DroneAid-Parts/OpenFC-Lite/hardware/OpenFC.kicad_pcb

## KiCad design hardware/OpenFC.kicad_pcb (2026-10-15)

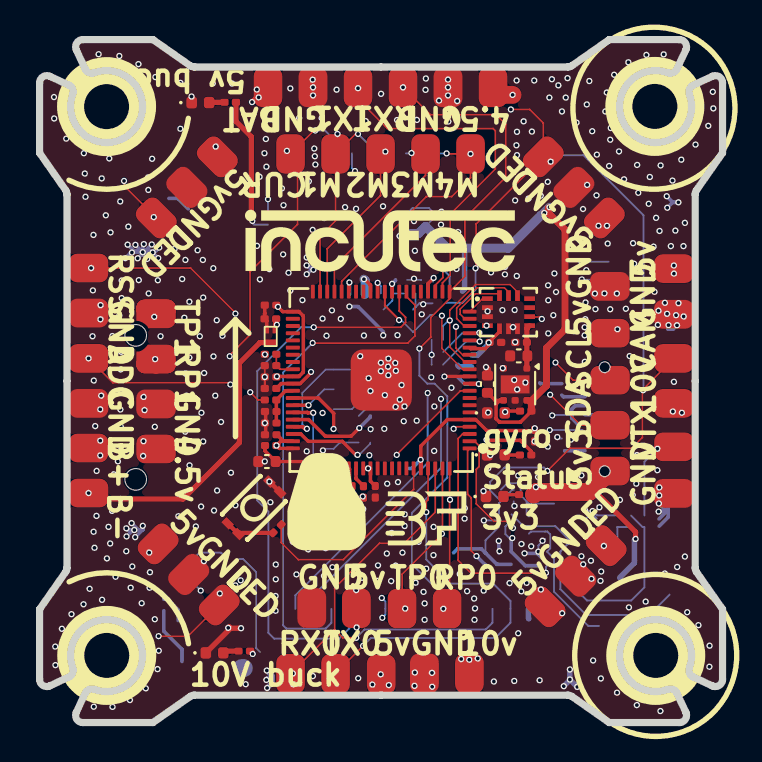
[picture p3: board OpenFC.kicad_pcb from above]

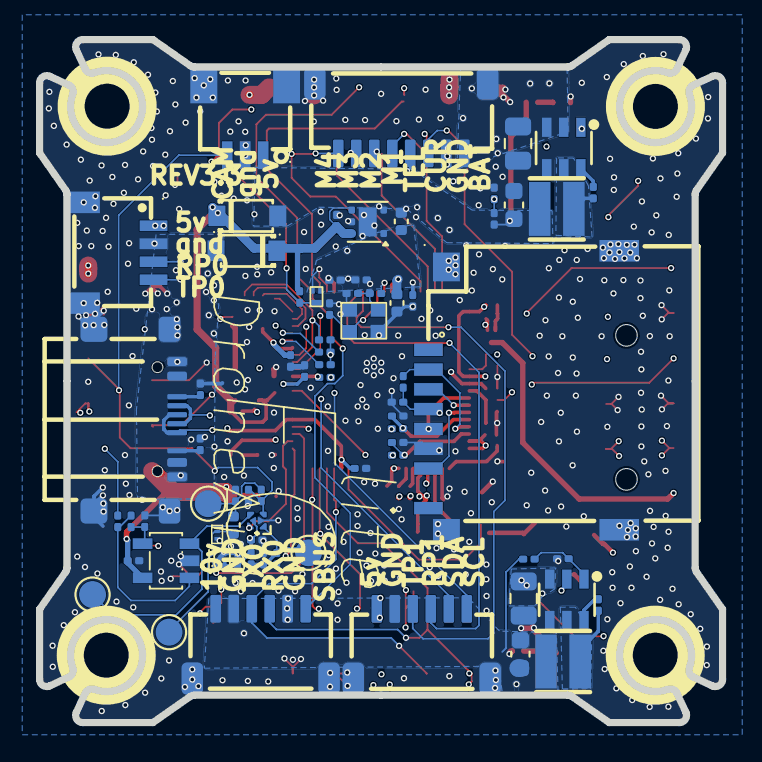
[picture p4: board OpenFC.kicad_pcb from below]

Board: 6 copper layers, 37.9 x 37.9 mm, 164 parts (72 on the bottom side), 82 nets.

Parts:
C1, C3, C5, C6, C7, C9, C10, C11, C12, C13, C14, C15, C16, C17, C18, C24, C25, C30, C33, C34, C35, C37, C39, C40, C41: 100n; C_0201_0603Metric
C2, C19, C20, C21, C31: 4.7uF; C_0402_1005Metric
C4, C8: 20p; C_0201_0603Metric
C22, C23: 4.7uF 50v; C_0805_2012Metric
C26, C27: 22uF; C_0603_1608Metric
C32, C42: 22uF; C_0402_1005Metric
C36: 470p; C_0201_0603Metric
C38: 1uF; C_0402_1005Metric
CN1: SM04B-SRSS-TB; CONN-SMD_4P-P1.00_SM04B-SRSS-TB-LF-SN
Card1: TF PUSH; TF-SMD_TF-PUSH
D1: LED_1_Blue; LED_0402_1005Metric
D4, D5, D7, D9: LED_1_Green; LED_0402_1005Metric
D6, D10: DSK24; SOD-123_L2.8-W1.8-LS3.7-RD
D8: SDM02U30LP3-7B; X3-DFN0603-2_L0.6-W0.3-RD
J1, J2, J3, J4, J5, J6, J7, J8, J9, J10, J11, J12, J13, J14, J15, J16, J17, J18, J19, J20, J21, J22, J23, J24, J25, J26, J27, J28, J29, J30, J31, J32, J33, J34, J35, J36, J37, J38, J39, J40, J41, J42, J43, J44, J47, J48, J49, J50, J51, J52, J53, J54, J55: 5V; small_pad
L1: AOTA-B201610S3R3-101-T; IND-SMD_L2.0-W1.6_AOTA-B201610S3R3-101-T
L2, L3: XRTC303020D4R7MBCA; IND-SMD_L3.0-W3.0_AFE303020S
P1: SM08B-SRSS-TB(LF)(SN); CONN-TH_SM08B-SRSS-TB-LF-SN
Q1, Q2: AP1606; DFN-3L_L1.0-W0.6-P0.65-BR
R1, R17, R21, R23: 100k; R_0201_0603Metric
R2, R9, R29, R30: 10k; R_0201_0603Metric
R3, R4, R13, R14: 5.1k; R_0201_0603Metric
R5, R6, R7, R8: 1k; R_0201_0603Metric
R10, R11, R12: 30R; R_0201_0603Metric
R15, R16, R31, R38: 75R; R_0201_0603Metric
R18, R26: 2.4k; R_0201_0603Metric
R22: 8.87k; R_0201_0603Metric
R24: 19.1k; R_0201_0603Metric
R25: 7.5k; R_0201_0603Metric
R28, R36, R37: 510R; R_0201_0603Metric
R32: 3.9k; R_0201_0603Metric
R33: 12k; R_0201_0603Metric
R34: 1.4k; R_0201_0603Metric
R35: 680R; R_0201_0603Metric
R39: 6.49k; R_0201_0603Metric
TP1, TP2, TP3, TP4: TestPoint; TestPoint_Pad_D1.5mm
U1: TS2306A 240GF MSM 9_C2976675; SW-SMD_4P-L3.0-W2.0-P0.85-LS3.5
U2: RP2354B_C39843328; QFN-80_L10.0-W10.0-P0.40-TL-EP3.4
U6, U16: LMR51635YDDCR; SOT-23-6_L2.9-W1.6-P0.95-LS2.8-BL
U7: LP5912-3.3DRVR; WSON-6-1EP_2x2mm_P0.65mm_EP1x1.6mm
U8, U14: SM06B-SRSS-TB(LF)(SN); CONN-SMD_SM06B-SRSS-TB-LF-SN
U9: BMI270; LGA-14_L3.0-W2.5-P0.50-BR
U10: SN74LVC1G3157DTBR; X2SON-6_L1.0-W0.8-BL
U11: COS8051SOT; SOT-23-5_L3.0-W1.7-P0.95-LS2.8-BR
U12: TLV7031DPWR; X2SON-4_L0.8-W0.8-P0.48-TL-A
U13: SM03B-SRSS-TB; CONN-SMD_SM03B-SRSS-TB-LF-SN-P
U15: LP5912-1.8DRVR; WSON-6-1EP_2x2mm_P0.65mm_EP1x1.6mm_ThermalVias
USB1: TYPE-C 16P QTWT; USB-TYPE-C-SMD_TYPE-C-16P-QTWT
X1: XTM25012000JT00351001; CRYSTAL-SMD_4P-L2.5-W2.0-BL-A

Connections:
+1.1V: C1.1, C2.1, C5.1, C20.1, L1.1, U2.10 (DVDD), U2.32 (DVDD), U2.51 (DVDD), U2.65 (VREG_FB)
+1.8V_GYRO: C33.1, C42.1, U9.8 (Vdd), U15.1 (OUT)
+3.3V: C6.1, C7.1, C9.1, C10.1, C11.1, C12.1, C13.1, C14.1, C18.1, C19.1, C32.1, C34.1, C35.1, C37.1, C39.1, C40.1, C41.1, Card1.4 (VDD), J28.1 (Pin_1_1), Q2.1 (G), R12.1, R13.1, R14.1, R28.1, R29.2, R30.1, R33.2, U2.5 (IOVDD), U2.15 (IOVDD), U2.24 (IOVDD), U2.29 (IOVDD), U2.35 (RUN), U2.41 (IOVDD), U2.50 (IOVDD), U2.59 (ADC_AVDD), U2.60 (IOVDD), U2.64 (VREG_VIN), U2.68 (USB_OTP_VDD), U2.69 (QSPI_IOVDD), U2.76 (IOVDD), U7.1 (OUT), U9.5 (Vdd_IO), U10.5 (VCC), U11.5 (+VS), U12.2 (VCC)
+4v5: C30.1, C31.1, D6.1 (K), D10.1 (K), J5.1 (Pin_1_1), J47.1 (Pin_1_1), R18.1, R39.1, U7.4 (EN), U7.6 (IN), U14.1, U15.4 (EN), U15.6 (IN)
+5V: C27.1, CN1.1, D6.2 (A), J3.1 (Pin_1_1), J4.1 (Pin_1_1), J16.1 (Pin_1_1), J17.1 (Pin_1_1), J22.1 (Pin_1_1), J25.1 (Pin_1_1), J30.1 (Pin_1_1), J40.1 (Pin_1_1), J55.1 (Pin_1_1), L3.2, R23.2, R26.1, U13.1
+5V_USB: D10.2 (A), USB1.A4 (VBUS), USB1.A9 (VBUS)
+10V: C26.1, J38.1 (Pin_1_1), J53.1 (Pin_1_1), L2.2, R21.2, R25.1, U8.1
+BATT: C22.1, C23.1, J29.1 (Pin_1_1), P1.1, R1.2, U6.3 (VIN), U16.2 (EN), U16.3 (VIN)
/BLACKBOX/FLASH_CS: Card1.2 (CD/DAT3), R30.2, U2.57 (GPIO46_ADC6)
/BLACKBOX/SPI1.MISO: Card1.7 (DAT0), U2.55 (GPIO44_ADC4)
/BLACKBOX/SPI1.MOSI: Card1.3 (CMD), U2.54 (GPIO43_ADC3)
/BLACKBOX/SPI1.SCK: Card1.5 (CLX), U2.53 (GPIO42_ADC2)
/IMU/CLKIN: U2.14 (GPIO15), U9.9 (INT2)
/IMU/CS: R29.1, U2.13 (GPIO14), U9.12 (CS)
/IMU/GYRO_INT: U2.12 (GPIO13), U9.4 (INT1)
/IMU/SPI0.MISO: U2.20 (GPIO20), U9.1 (SDO/SA0)
/IMU/SPI0.MOSI: U2.19 (GPIO19), U9.14 (SDA)
/IMU/SPI0.SCK: U2.18 (GPIO18), U9.13 (SCL)
/OSD/OSD_EN: U2.2 (GPIO5), U10.6 (S)
/OSD/OSD_LVL: R32.2, R33.1, R34.2, TP1.1 (1_1), U10.1 (B2)
/OSD/OSD_SYNC: U2.3 (GPIO6), U12.1 (OUT)
/OSD/OSD_W: R32.1, U2.1 (GPIO4)
/OSD/VIDEO_IN: J32.1 (Pin_1_1), R31.1, R35.2, U10.3 (B1), U13.3
/OSD/VIDEO_OUT: J34.1 (Pin_1_1), R38.2
/OSD/VID_DC: C38.2, D8.1 (C), TP3.1 (1_1), U12.4 (IN+)
/OSD/VID_FILT: C36.1, C38.1, R35.1, TP2.1 (1_1)
/PADS/ADC2: J8.1 (Pin_1_1), R8.2
/PADS/BUZZER-: J21.1 (Pin_1_1), Q1.3 (D)
/PADS/CURRENT: J33.1 (Pin_1_1), P1.3, R6.2
/PADS/I2C0.SCL: J15.1 (Pin_1_1), R13.2, U2.17 (GPIO17), U14.6
/PADS/I2C0.SDA: J18.1 (Pin_1_1), R14.2, U2.16 (GPIO16), U14.5
/PADS/LED_STRIP: J10.1 (Pin_1_1), J11.1 (Pin_1_1), J23.1 (Pin_1_1), J24.1 (Pin_1_1), Q2.3 (D), R18.2
/PADS/M1: J35.1 (Pin_1_1), P1.5, U2.39 (GPIO31)
/PADS/M2: J37.1 (Pin_1_1), P1.6, U2.38 (GPIO30)
/PADS/M3: J39.1 (Pin_1_1), P1.7, U2.37 (GPIO29)
/PADS/M4: J41.1 (Pin_1_1), P1.8, U2.36 (GPIO28)
/PADS/PIOUART0_RX: CN1.3, J44.1 (Pin_1_1), U2.80 (GPIO3)
/PADS/PIOUART0_TX: CN1.4, J43.1 (Pin_1_1), U2.79 (GPIO2)
/PADS/PU1RX: J54.1 (Pin_1_1), P1.4, U2.28 (GPIO27), U14.3
/PADS/PU1TX: J52.1 (Pin_1_1), U2.27 (GPIO26), U14.4
/PADS/RSSI: J2.1 (Pin_1_1), R7.2
/PADS/U1RX: J9.1 (Pin_1_1), U2.21 (GPIO21), U8.6
/PADS/UART0_RX: J48.1 (Pin_1_1), U2.78 (GPIO1), U8.4
/PADS/UART0_TX: J49.1 (Pin_1_1), U2.77 (GPIO0), U8.3
/PADS/UART1_TX: J13.1 (Pin_1_1), U2.22 (GPIO22)
/POWER/1.8V_PG: D9.2 (A), R39.2, U15.3 (PG)
/POWER/10V_ENABLE: U2.9 (GPIO11), U6.2 (EN)
/RP2350A/ADC_VBAT: C3.2, R1.1, R2.2, U2.52 (GPIO41_ADC1)
/RP2350A/BEEPER: Q1.1 (G), R17.2, U2.4 (GPIO7)
/RP2350A/D+: R11.2, USB1.A6 (DP1), USB1.B6 (DP2)
/RP2350A/D-: R10.1, USB1.A7 (DN1), USB1.B7 (DN2)
/RP2350A/LED0: R15.1, U2.11 (GPIO12)
/RP2350A/LED_STRIP_L: Q2.2 (S), U2.23 (GPIO23)
/RP2350A/XIN: C4.2, U2.30 (XIN), X1.1
/RP2350A/XOUT: R5.1, U2.31 (XOUT)
GND: C1.2, C2.2, C3.1, C4.1, C5.2, C6.2, C7.2, C8.1, C9.2, C10.2, C11.2, C12.2, C13.2, C14.2, C15.2, C16.2, C17.2, C18.2, C19.2, C20.2, C21.2, C22.2, C23.2, C26.2, C27.2, C30.2, C31.2, C32.2, C33.2, C34.2, C35.2, C36.2, C37.2, C39.2, C40.2, C41.2, C42.2, CN1.2, CN1.5, CN1.6, Card1.6 (VSS), Card1.10, Card1.11, Card1.12, Card1.13, D1.1 (K), D4.1 (K), D5.1 (K), D7.1 (K), D8.2 (A), D9.1 (K), J1.1 (Pin_1_1), J6.1 (Pin_1_1), J7.1 (Pin_1_1), J12.1 (Pin_1_1), J14.1 (Pin_1_1), J19.1 (Pin_1_1), J20.1 (Pin_1_1), J26.1 (Pin_1_1), J27.1 (Pin_1_1), J31.1 (Pin_1_1), J36.1 (Pin_1_1), J42.1 (Pin_1_1), J50.1 (Pin_1_1), J51.1 (Pin_1_1), P1.2, P1.9, P1.10, Q1.2 (S), R2.1, R3.1, R4.1, R17.1, R22.2, R24.2, R31.2, R34.1, R36.2, U1.1, U2.62 (VREG_PGND), U2.81 (GND), U6.4 (GND), U7.3 (GND), U7.5 (PG), U7.7 (EP), U8.2, U8.5, U8.7, U8.8, U9.2 (SDx/AH1/Qvar1), U9.3 (SCx/AH2/Qvar2), U9.6 (GND), U9.7 (GND), U10.2 (GND), U11.2 (-VS), U12.3 (IN-), U12.5 (VEE), U13.2, U13.4, U13.5, U14.2, U14.7, U14.8, U15.5 (GND), U15.7 (EP), U16.4 (GND), USB1.0 (EH), USB1.A1 (GND), USB1.A12 (GND), X1.2 (GND), X1.4 (GND)
unnamed: C8.2, R5.2, X1.3
unnamed: D1.2 (A), R16.2
unnamed: D4.2 (A), R25.2
unnamed: D5.2 (A), R26.2
unnamed: D7.2 (A), R28.2
unnamed: R9.1, U1.2
unnamed: R15.2, R16.1
unnamed: C15.1, R6.1, U2.49 (GPIO40_ADC0)
unnamed: C16.1, R7.1, U2.56 (GPIO45_ADC5)
unnamed: C17.1, R8.1, U2.58 (GPIO47_ADC7)
unnamed: R9.2, U2.75 (QSPI_SS)
unnamed: R10.2, U2.66 (USB_DM)
unnamed: R11.1, U2.67 (USB_DP)
unnamed: C21.1, R12.2, U2.61 (VREG_AVDD)
unnamed: L1.2, U2.63 (VREG_LX)
unnamed: C24.2, U6.6 (CB)
unnamed: R21.1, R22.1, U6.1 (FB)
unnamed: C24.1, L2.1, U6.5 (SW)
unnamed: TP4.1 (1_1), U10.4 (A), U11.3 (IN+)
unnamed: R36.1, R37.1, U11.4 (IN-)
unnamed: R37.2, R38.1, U11.1 (OUT)
unnamed: C25.2, U16.6 (CB)
unnamed: R23.1, R24.1, U16.1 (FB)
unnamed: C25.1, L3.1, U16.5 (SW)
unnamed: R3.2, USB1.A5 (CC1)
unnamed: R4.2, USB1.B5 (CC2)
