DroneAid-Parts/OpenFC-Lite/(commit log)

2026-10-12 firmware: rebuild uf2 for the rev3.3 pin map (#44)
    * firmware: rebuild uf2 for the rev3.3 pin map
    The previous uf2 carried the Rev 2 rework map (M1/M4 on the UART1 pads,
    receiver on the I2C pads), which does not match rev3.3. Rebuilt from
    betaflight def914ce6 with config 6c83a9f (OpenDrone-hw/betaflight-config#1),
    every pin checked against the rev3.3 netlist. Not yet flashed on hardware.
    Removes: the Rev 2 rework uf2.
    * firmware: revision in the uf2 name, archive the Rev 2 image
    firmware/OpenFC-Lite-rev3.3_*.uf2 is the current image. The Rev 2 image
    (I/O remap for the shorted nets) moves to firmware/archive/ under a rev2
    name. AGEN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
2026-10-12 docs(agents): cut AGENTS.md to validate, boundaries, pointers (#45)
    AGENTS.md 202 -> 18 lines. Removes architecture, tables, procedures and
    state; keeps only hard boundaries and the validation command.
    Claude-Session: https://claude.ai/code/session_017Ye54fa9v5VP179Xbw465R
2026-10-13 docs: restore AGENTS.md technical write-up (#47)
    Reverts the AGENTS.md cut and the README pointer change; the write-up is board documentation, not duplicated elsewhere.
    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
2026-10-15 Apply DroneAid rebrand and configure upstream sync
    [OpenFC.kicad_pcb]
